sannong/apflights/img/DSCN0288.JPG

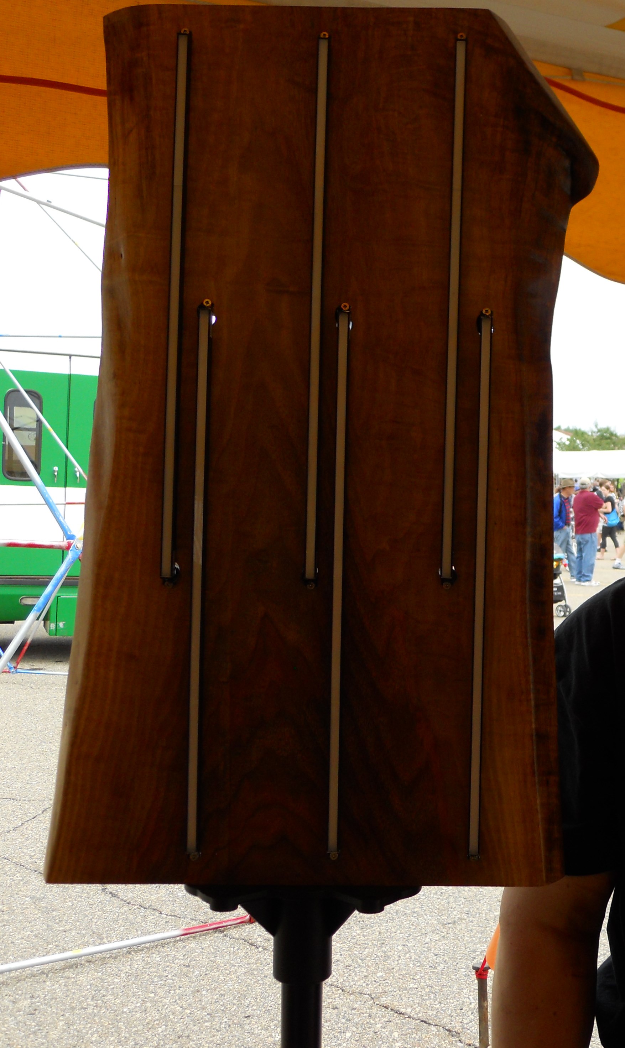
img/DSCN0288.JPG
