sannong/apflights/img/DSCN0460.jpg

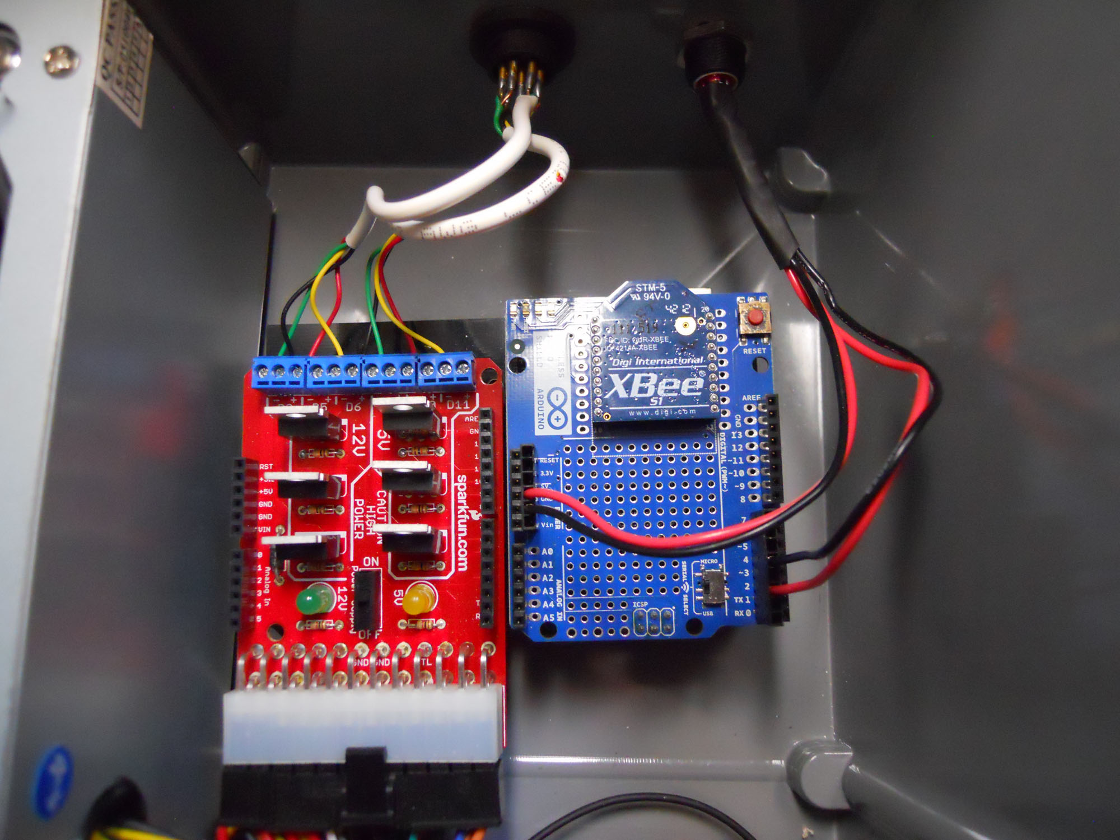
img/DSCN0460.jpg
