sannong/apflights/sch/host.pdf

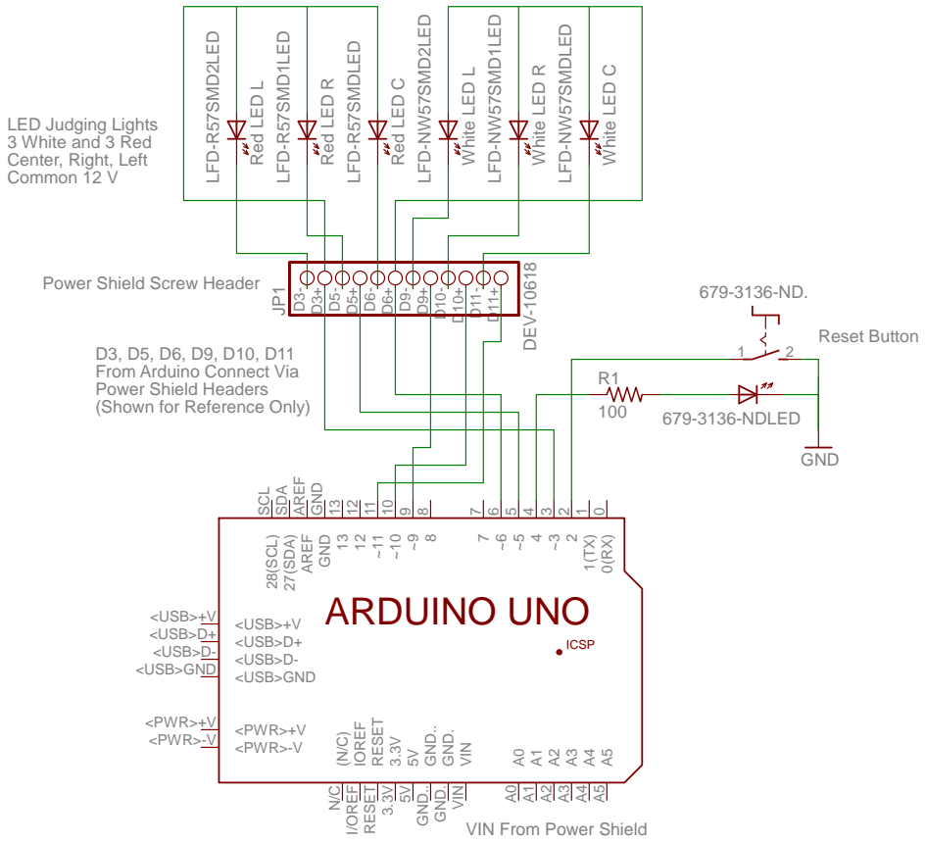
[picture p3: figure]
Power Shield Headers (Shown for Reference Only); LED Judging Lights; Center, Right, Left; 3 White and 3 Red; Reset Button; Common 12 V; VIN From Power Shield; D3, D5, D6, D9, D10, D11 From Arduino Connect Via; Power Shield Screw Header; GND; DEV-10618; Red LED L; Red LED R; Red LED C; White LED L; White LED R; White LED C; 28(SCL) SCL; 27(SDA) SDA; AREF AREF GND GND 13 13; <PWR>-V <PWR>-V <PWR>+V <PWR>+V; 679-3136-NDLED; LFD-R57SMD2LED; LFD-R57SMD1LED; LFD-R57SMDLED; LFD-NW57SMD2LED; LFD-NW57SMD1LED; LFD-NW57SMDLED; ARDUINO UNOICSP

# 0(RX) 0 A5 A5 A4 A4 A3 A3 A2 A2 A1 A1 A0 A0

VIN VIN GND. GND. GND.. GND.. 5V 5V 3.3V 3.3V RESET RESET IOREF I/OREF (N/C) N/C

<USB>GND <USB>GND <USB>D- <USB>D- <USB>D+ <USB>D+ <USB>+V <USB>+V
