sannong/apflights/sch/module.pdf

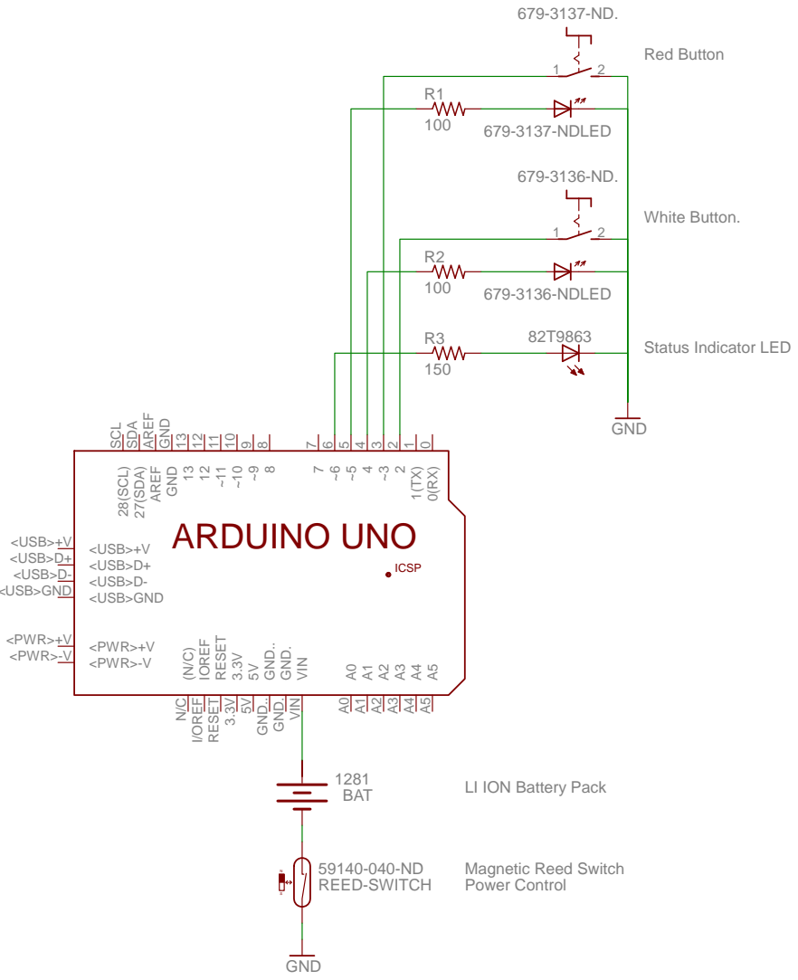
[picture p4: figure]
White Button.; Red Button; Magnetic Reed Switch Power Control; LI ION Battery Pack; Status Indicator LED; GND; BAT; REED-SWITCH; 28(SCL) SCL; 27(SDA) SDA; AREF AREF GND GND 13 13; <PWR>-V <PWR>-V <PWR>+V <PWR>+V; 679-3137-NDLED; 679-3136-NDLED; ARDUINO UNOICSP

# 0(RX) 0 A5 A5 A4 A4 A3 A3 A2 A2 A1 A1 A0 A0

VIN VIN GND. GND. GND.. GND.. 5V 5V 3.3V 3.3V RESET RESET IOREF I/OREF (N/C) N/C

<USB>GND <USB>GND <USB>D- <USB>D- <USB>D+ <USB>D+ <USB>+V <USB>+V
