sannong/apflights/sch/shield_connections.pdf

Arduino Uno | Wireless Shield | Xbee Module
| External Button/LED
| Connections Use Wirless
Digital Header | Shield Header

Analog/Power Headers

# Module Connections

Li Ion Battery

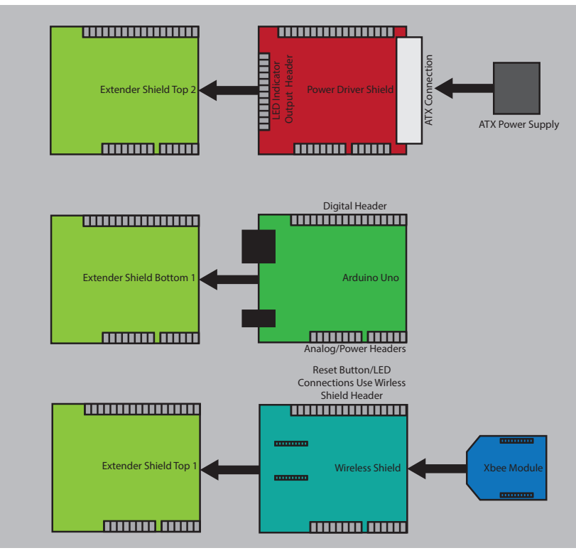
[picture p5: figure]
Extender Shield Top 2; Extender Shield Bottom 1; Extender Shield Top 1; Arduino Uno; Analog/Power Headers; Wireless Shield; Xbee Module; Power Driver Shield; ATX Connection; ATX Power Supply; LED Indicator; Output Header; Digital Header; Reset Button/LED Connections Use Wirless Shield Header

# Base Station Connections
