sannong/apflights/img/DSCN0250.JPG

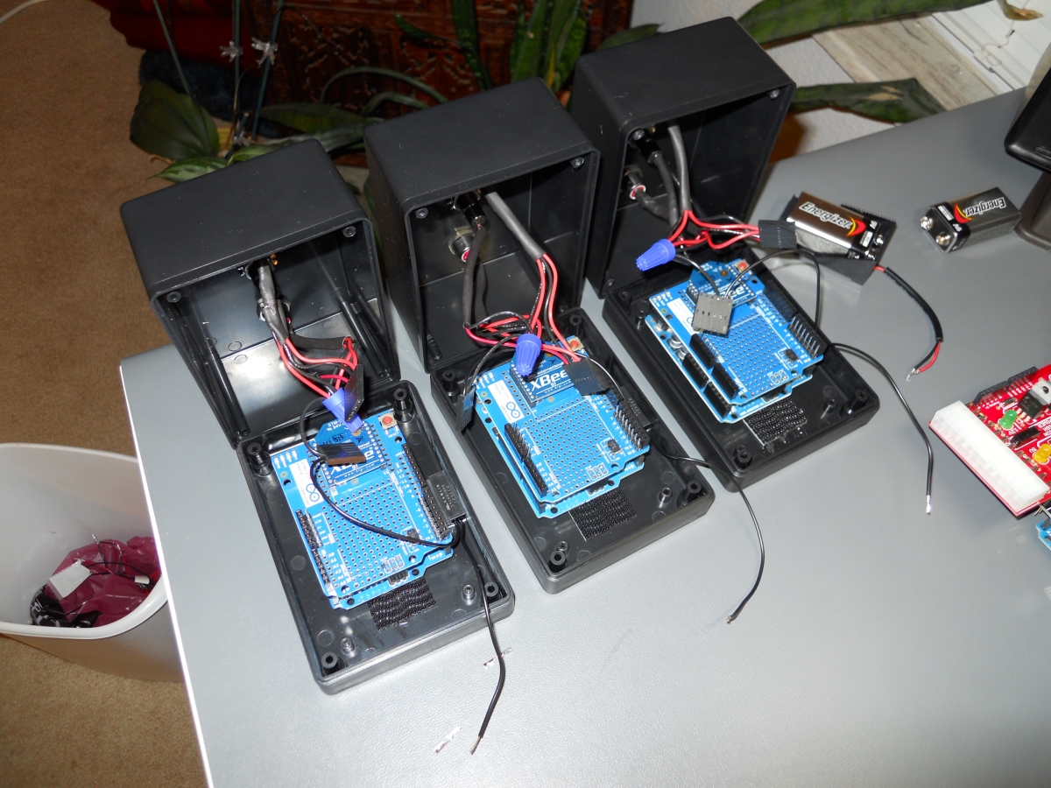
img/DSCN0250.JPG
