sannong/apflights/img/DSCN0252.JPG

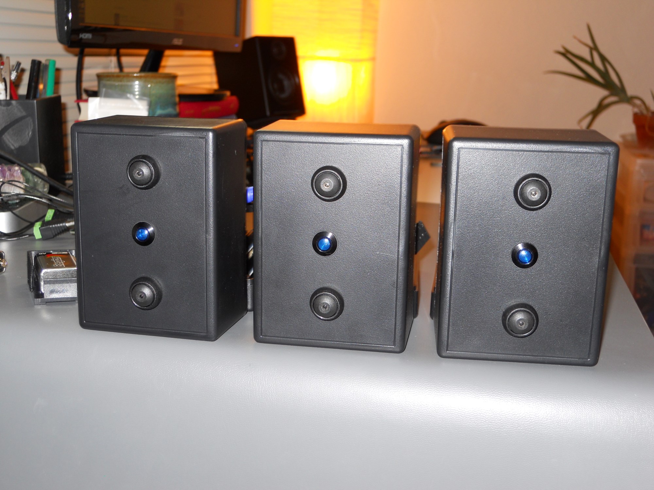
img/DSCN0252.JPG
