sannong/apflights/img/DSCN0254.JPG

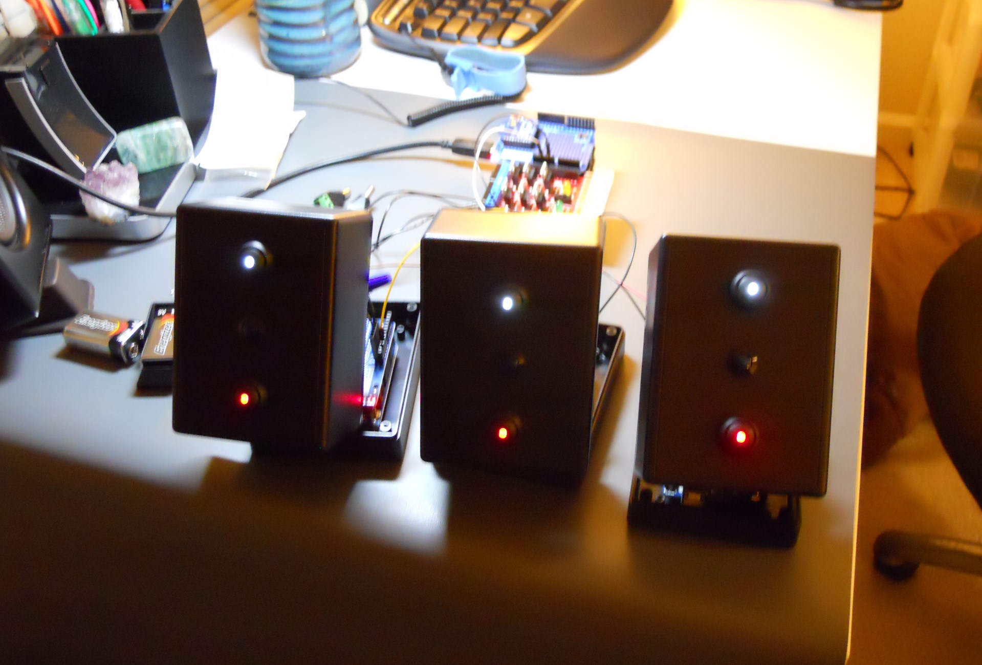
img/DSCN0254.JPG
