sannong/apflights/img/DSCN0255.JPG

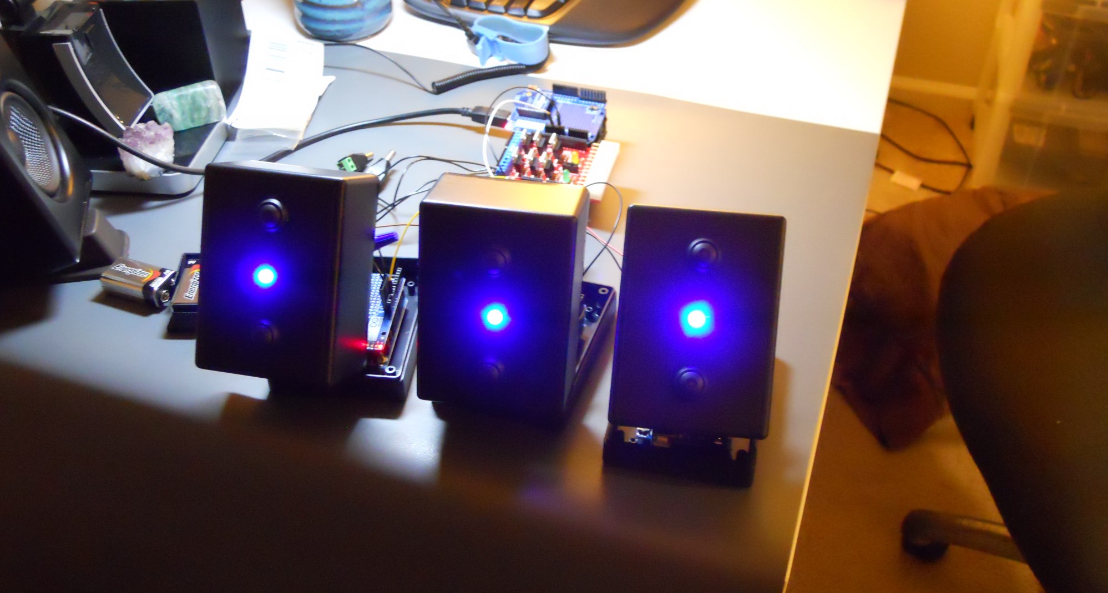
img/DSCN0255.JPG
