sannong/apflights/img/DSCN0260.JPG

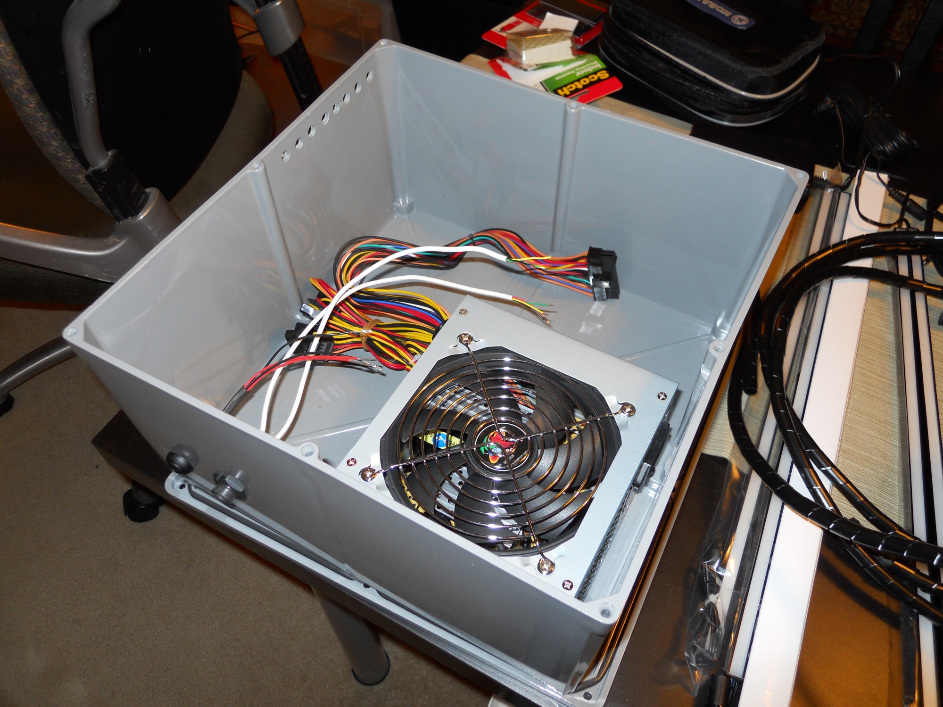
img/DSCN0260.JPG
