sannong/apflights/img/DSCN0455.jpg

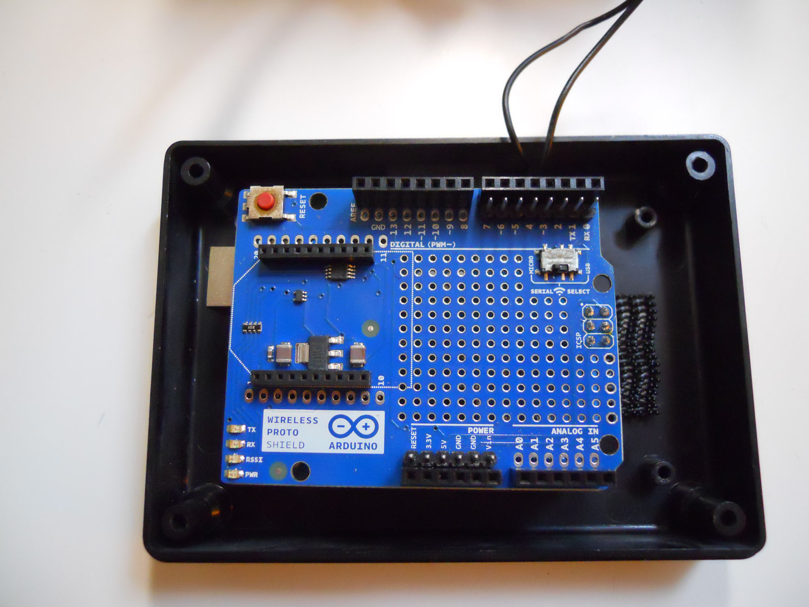
img/DSCN0455.jpg
