sannong/apflights/img/DSCN0456.jpg

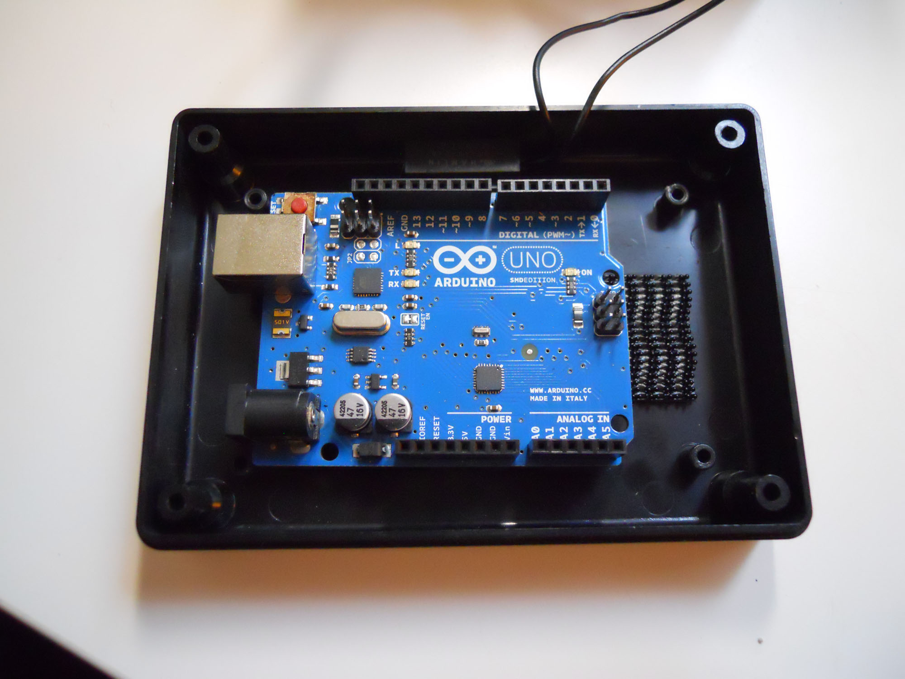
img/DSCN0456.jpg
