sannong/apflights/img/DSCN0457.jpg

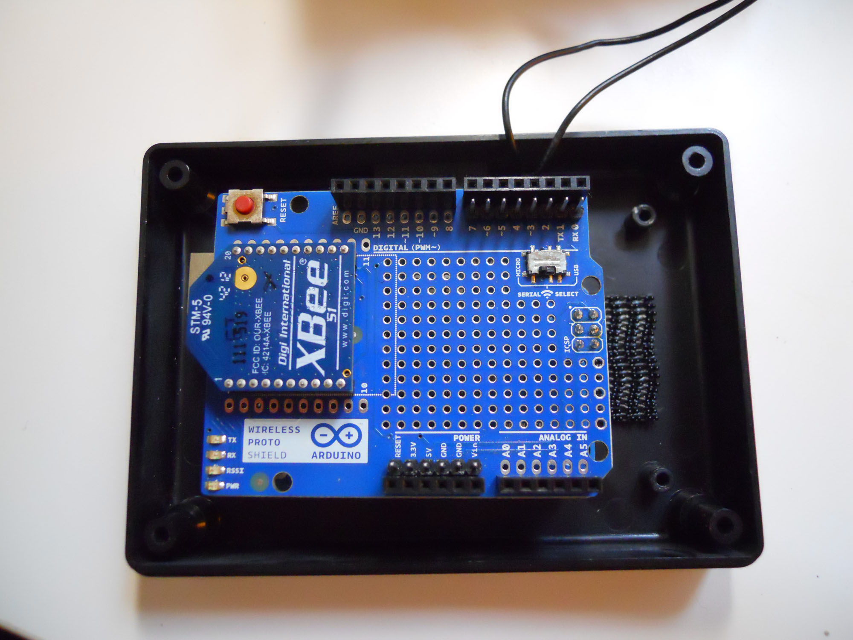
img/DSCN0457.jpg
