sannong/apflights/img/DSCN0458.jpg

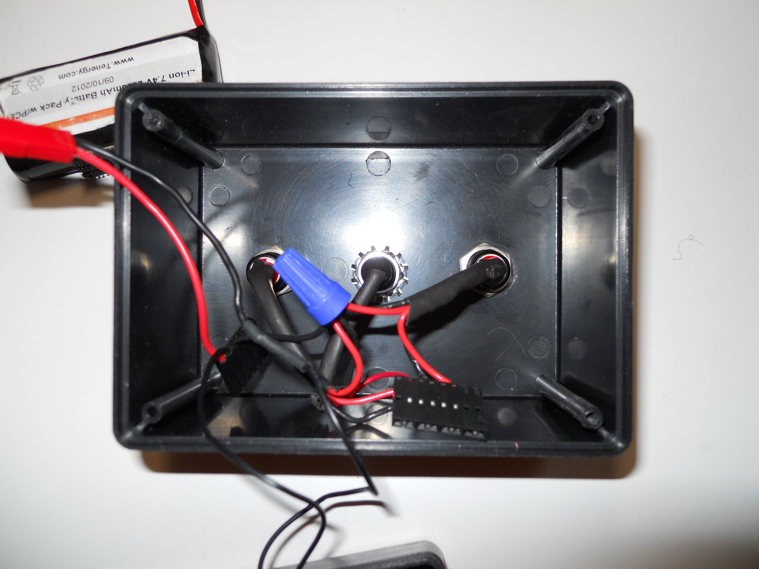
img/DSCN0458.jpg
