sannong/apflights/img/DSCN0459.jpg

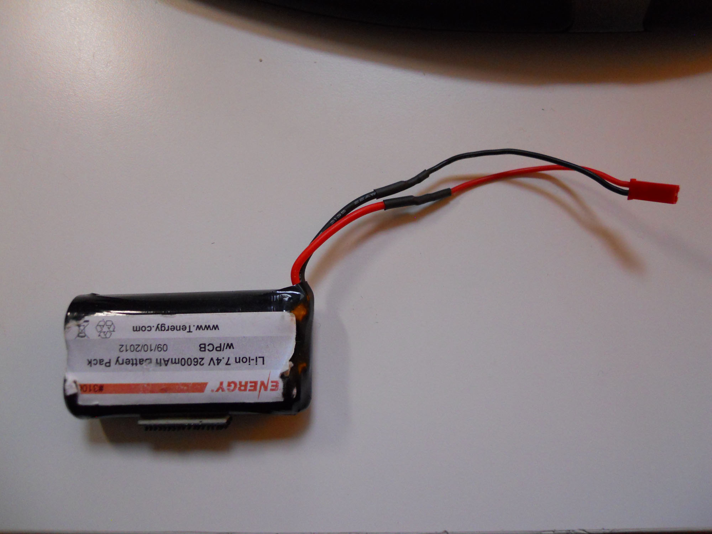
img/DSCN0459.jpg
