sannong/apflights/img/DSCN0461.jpg

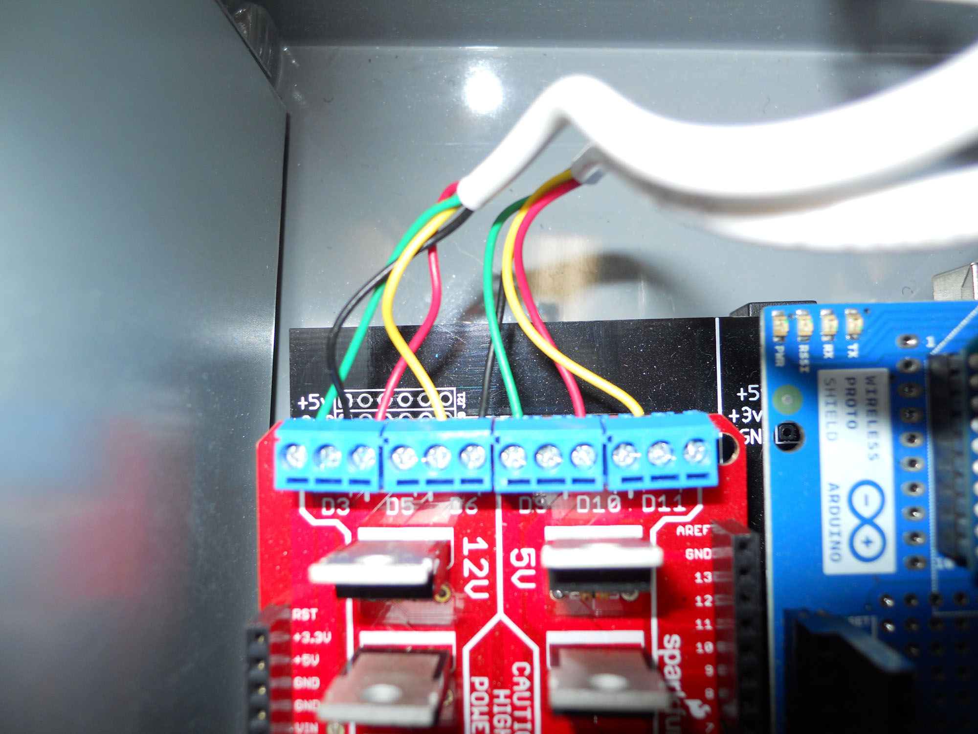
img/DSCN0461.jpg
