sannong/apflights/img/DSCN0462.jpg

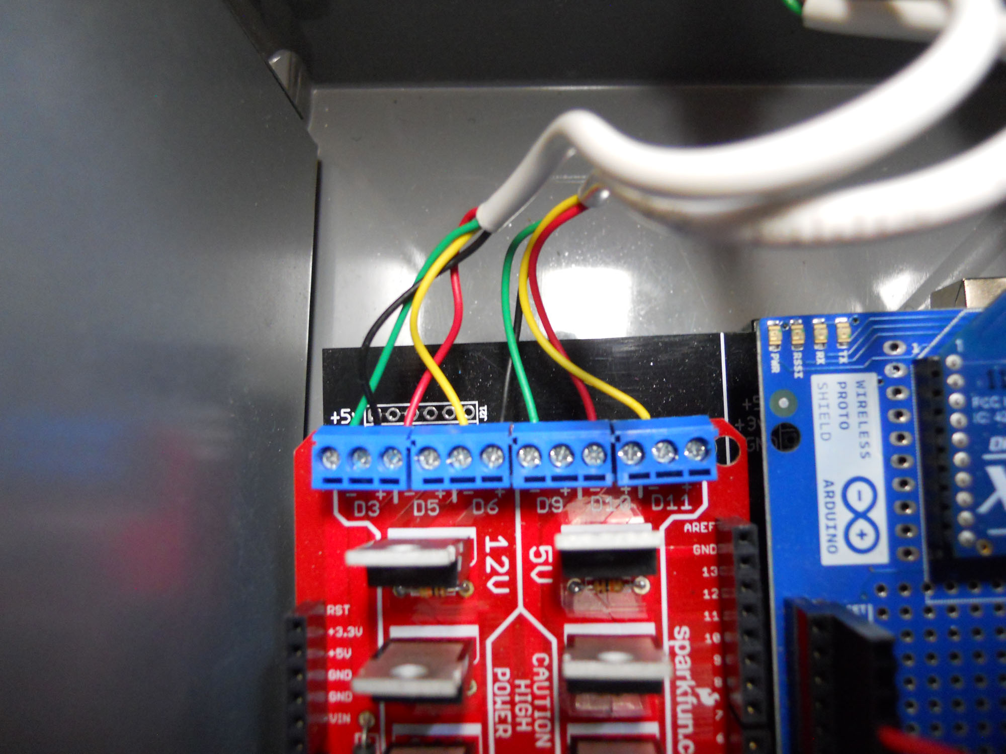
img/DSCN0462.jpg
