sannong/apflights/img/DSCN0463.jpg

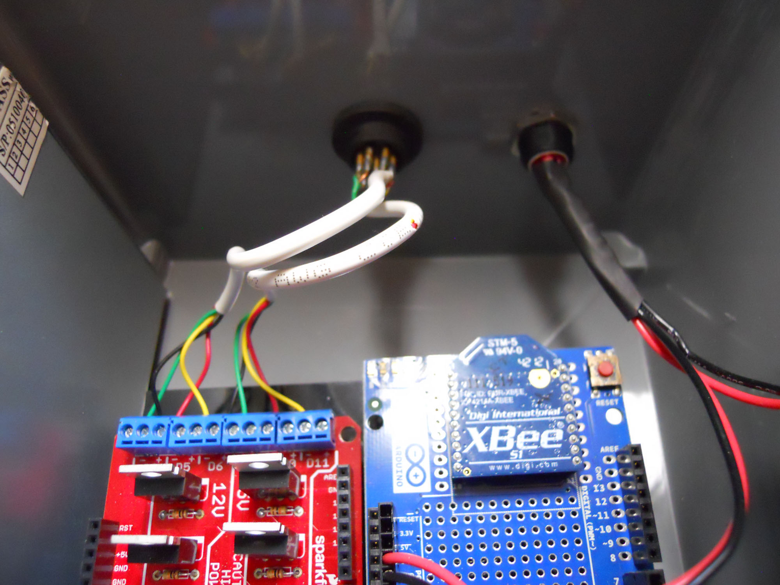
img/DSCN0463.jpg
