sannong/apflights/img/DSCN0464.jpg

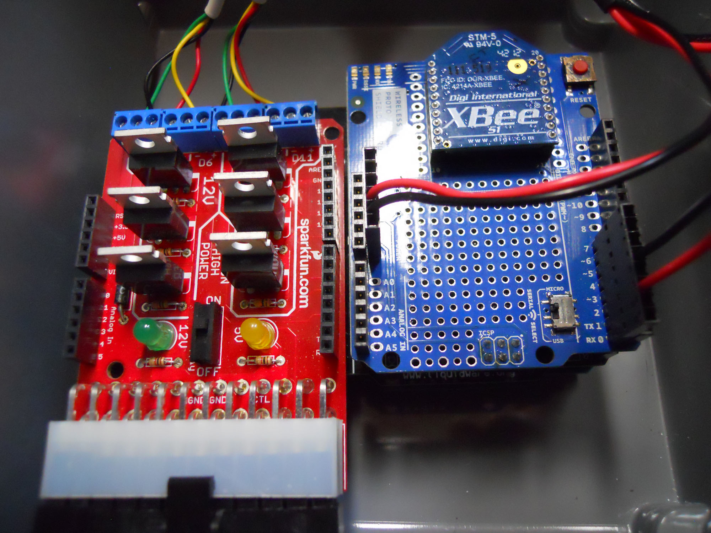
img/DSCN0464.jpg
