sannong/apflights/img/DSCN0465.jpg

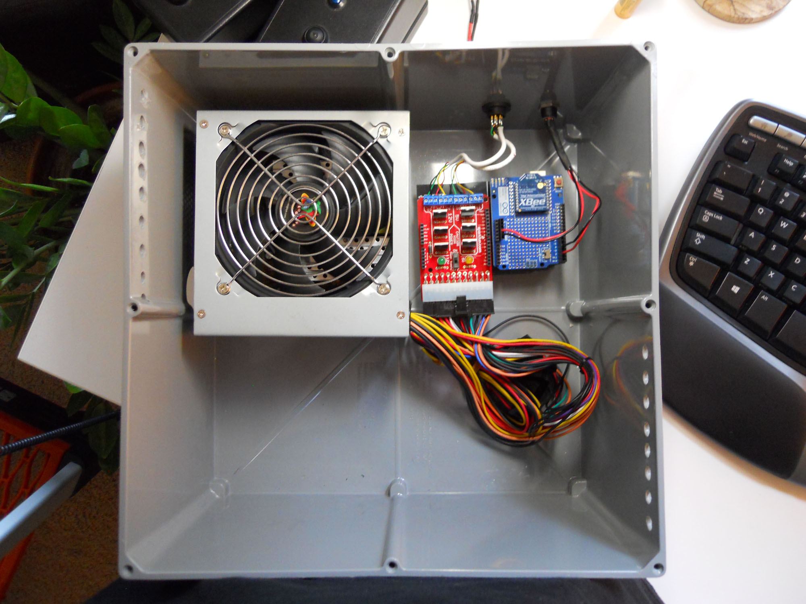
img/DSCN0465.jpg
