sannong/apflights/img/DSCN0466.jpg

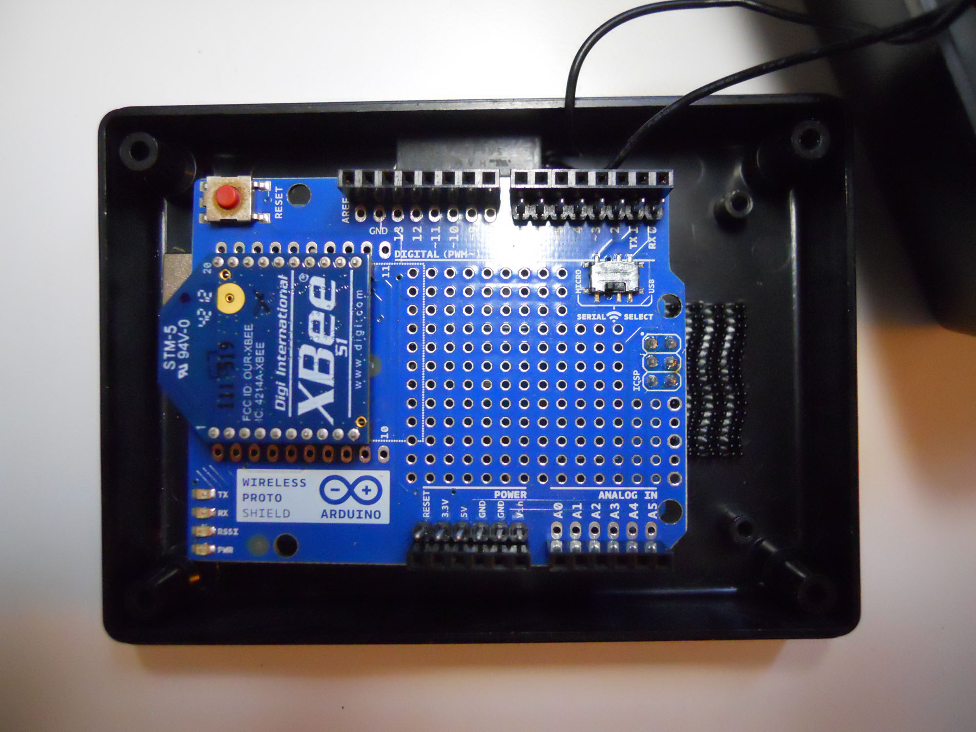
img/DSCN0466.jpg
