sannong/apflights/img/DSCN0467.jpg

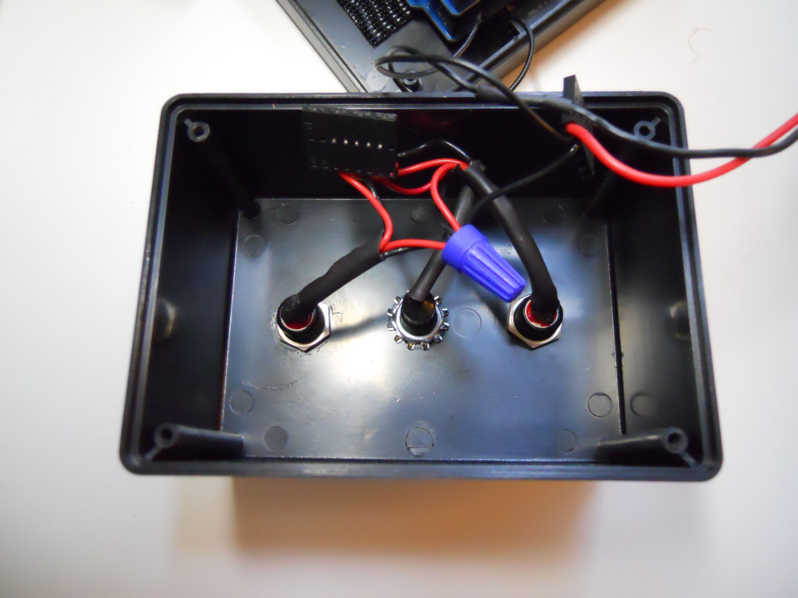
img/DSCN0467.jpg
