sannong/apflights/img/DSCN0468.jpg

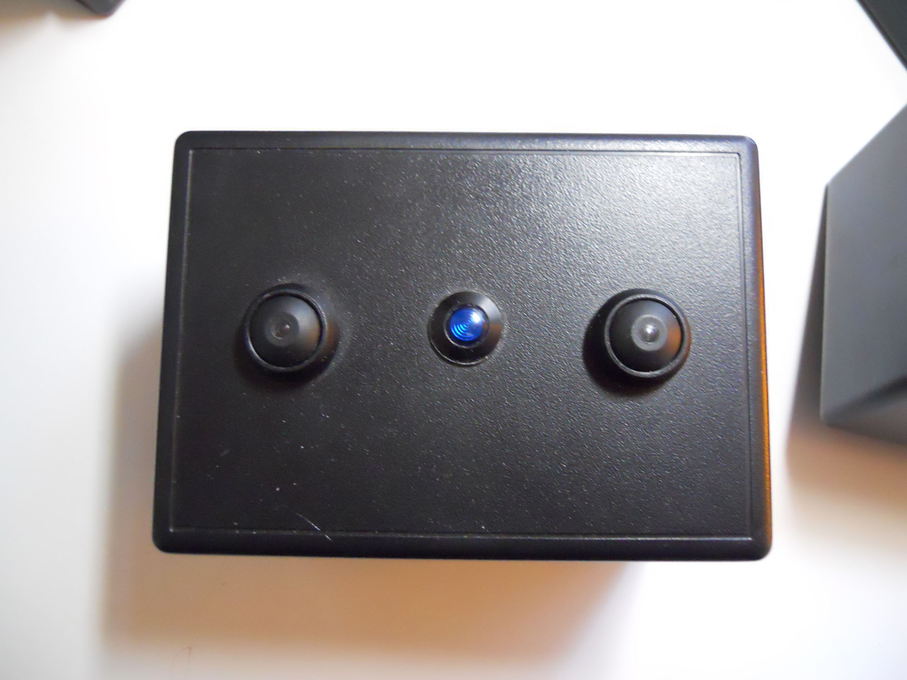
img/DSCN0468.jpg
