sannong/apflights/img/DSCN0469.jpg

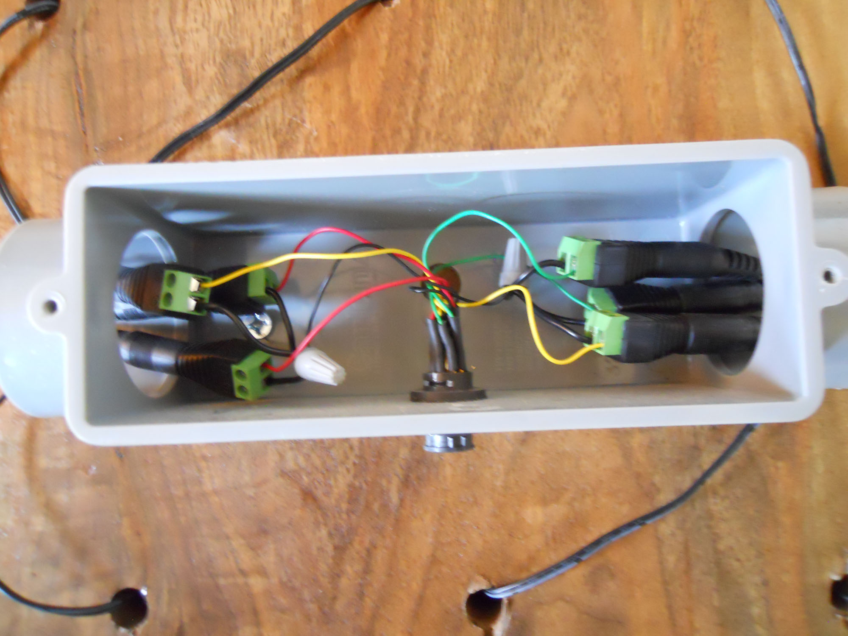
img/DSCN0469.jpg
