sannong/apflights/img/DSCN0470.jpg

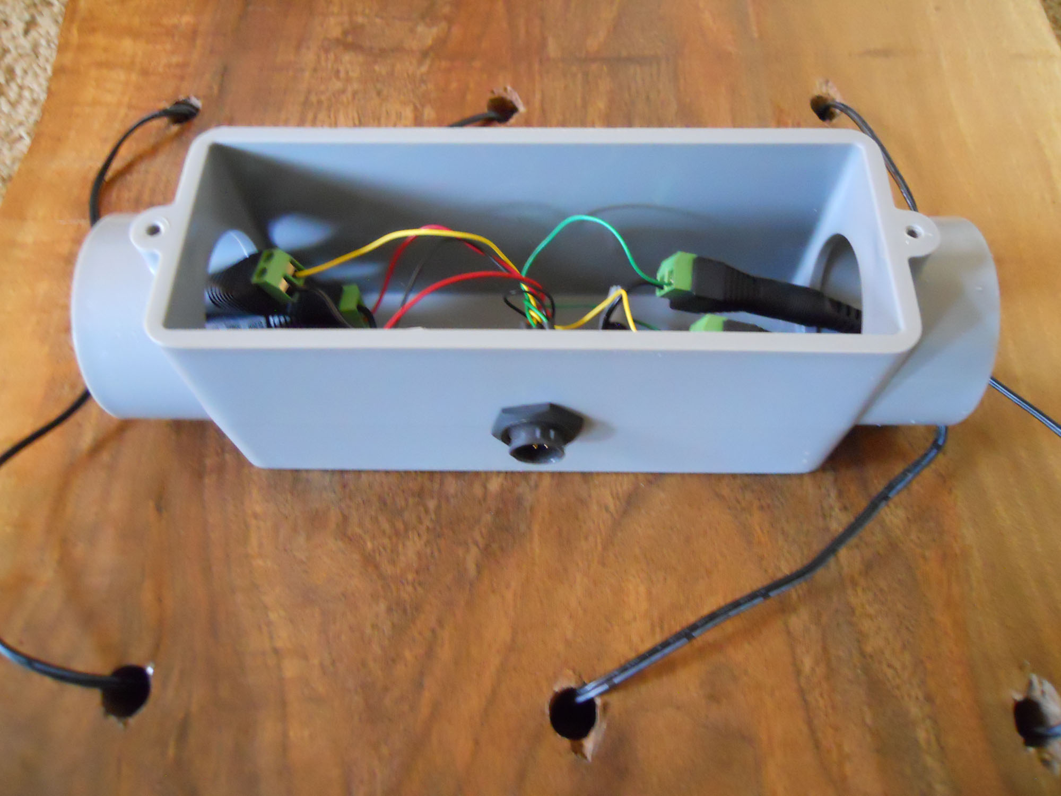
img/DSCN0470.jpg
