sannong/apflights/img/DSCN0471.jpg

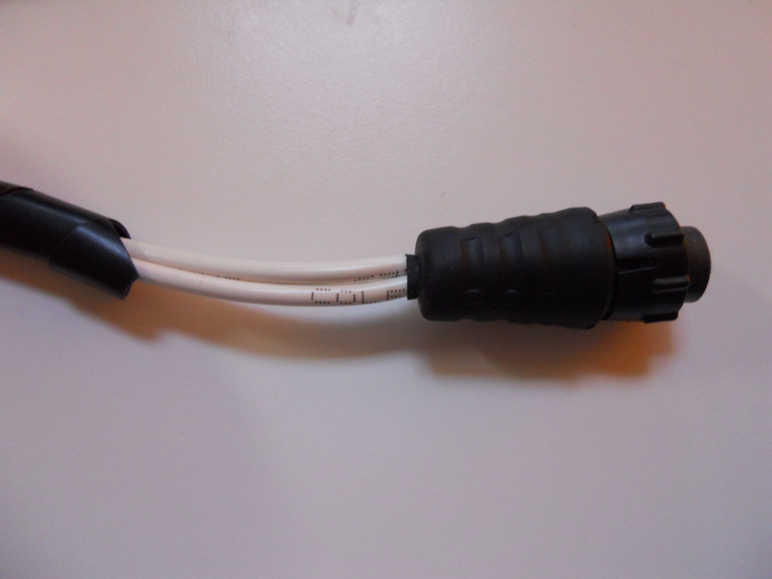
img/DSCN0471.jpg
