sannong/apflights/img/DSCN0472.jpg

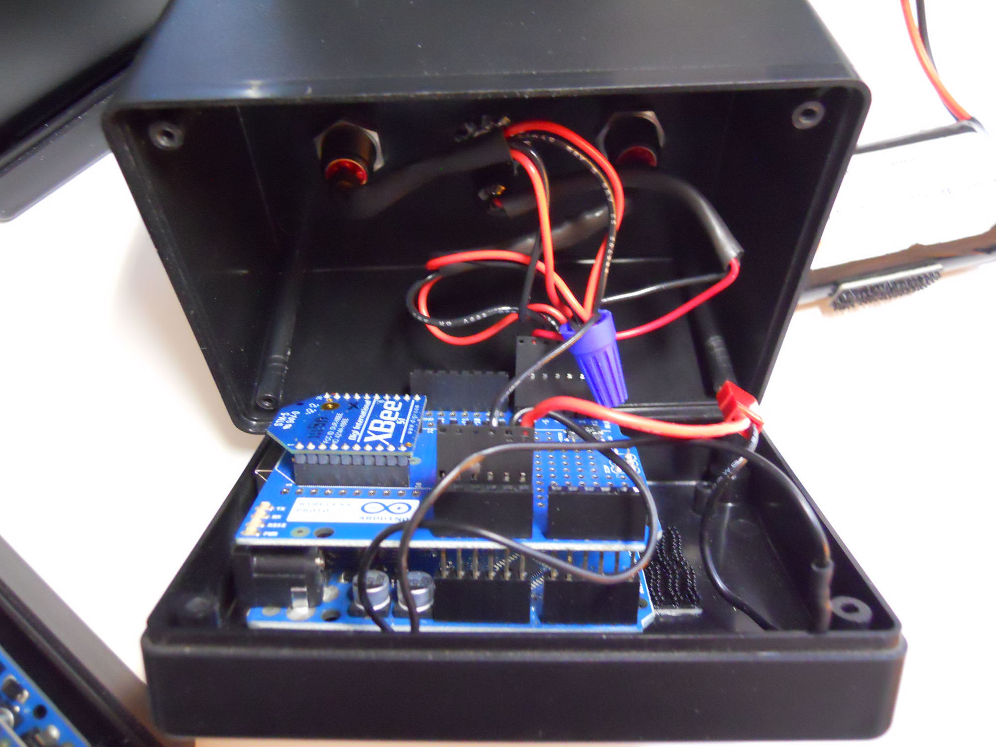
img/DSCN0472.jpg
