sannong/apflights/img/DSCN0473.jpg

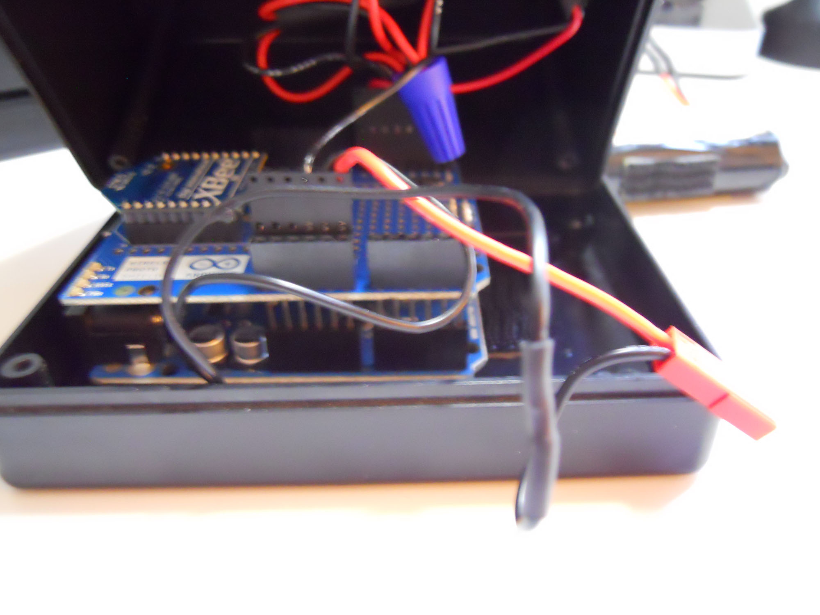
img/DSCN0473.jpg
