sannong/apflights/img/DSCN0474.jpg

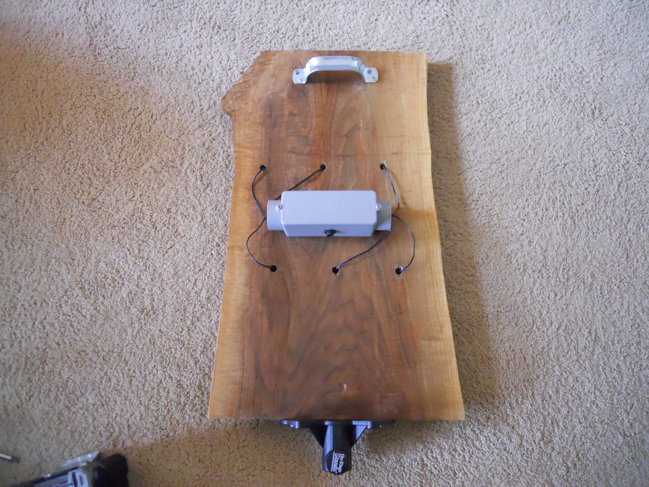
img/DSCN0474.jpg
