sannong/apflights/img/DSCN0475.jpg

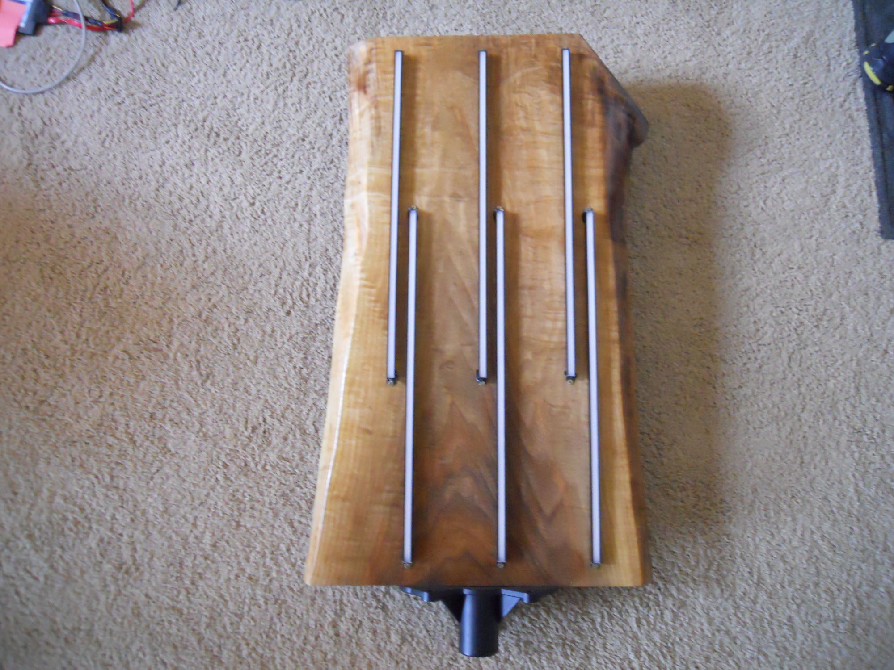
img/DSCN0475.jpg
