sannong/apflights/sch/BOM.xlsx

Required Parts
Index | Part Number | Description | Distributor | Quantity | Unit Price USD | Extended Price USD
 | 100QBK-ND | RES 100 OHM 1/4W 5% CARBON FILM (current control for button LED) | Digikey | 7 | 0.059 | $0.41
 | 150QBK-ND | RES 150 OHM 1/4W 5% CARBON FILM (current control for indicator LED) | Digikey | 3 | 0.059 | $0.18
 | 1050-1023-ND | ARDUINO SHIELD - WIRELESS | Digikey | 4 | 19.32 | $77.28
 | 1050-1041-ND | ARDUINO UNO SMD REV3 | Digikey | 4 | 24.64 | $98.56
 | 602-1273-ND | MOD XBEE 802.15.4 1MW W/PCB ANT | Digikey | 4 | 19 | $76.00
 | DEV-10618 | Power Driver Shield Kit | Sparkfun | 1 | 19.95 | $19.95
 | n/a | DoubleWide Extender Shield (http://www.liquidware.com/shop/show/DWX/DoubleWide+ExtenderShield) | Liquidware | 1 | 19.65 | $19.65
 | WRL-11812 | SparkFun XBee Explorer USB (used to program the Xbee module) http://www.sparkfun.com/products/11812 | Sparkfun | 1 | 24.95 | $24.95
 | PRT-08830 | Heat Shrink - Black 5' x 1/4" | Sparkfun | 1 | 1.95 | $1.95
 | WM2510-ND | CONN TERM FEMALE 22-24AWG TIN | Digikey | 32 | 0.0882 | $2.82
 | WM2806-ND | CONN HOUSING 8POS .100 SINGLE | Digikey | 4 | 0.7 | $2.80
 | WM8078-ND | CONN HEADER 8POS .100" STR TIN | Digikey | 4 | 0.9 | $3.60
 | WM2804-ND | CONN HOUSING 6POS .100 SINGLE | Digikey | 4 | 0.62 | $2.48
 | WM8076-ND | CONN HEADER 6POS .100" STR TIN | Digikey | 4 | 0.77 | $3.08
 | 1281 | Tenergy TLP-4000 Universal 1A Smart Charger for Li-Ion/Polymer Battery Pack (3.7V-14.8V 1-4 Cell) | all-battery.com | 1 | 24.95 | $24.95
 | 31004 | AT(i): Tenergy Li-Ion 18650 7.4V 2600mAh PCB Protected Battery Module w/ 22AWG Bare Leads | all-battery.com | 3 | 13.99 | $41.97
 | 80005 | A Pair of BEC (JST) Male and Female Connectors with Leads | all-battery.com | 4 | 2.28 | $9.12
 |  |  |  |  | Subtotal: | $409.75
Interchangeable Parts
Index | Part Number | Description | Distributor | Quantity | Unit Price USD | Extended Price USD
 | 679-3136-ND | SWITCH PUSHBUTTON SPST-NO 2A 24V | Digikey | 3 | 18.72 | $56.16
 | 679-3137-ND | SWITCH PUSHBUTTON SPST-NO 2A 24V | Digikey | 3 | 15.92 | $47.76
 | 679-3122-ND | SWITCH PUSHBUTTON SPST-NO 2A 24V | Digikey | 1 | 18.83 | $18.83
 | 82T9863 | LED PANEL MOUNT INDICATOR, BLUE, 3V | Newark | 3 | 12.8 | $38.40
 | 59140-040-ND | SENSOR MAGNETIC SPST-NC .5A | Digikey | 3 | 4.81 | $14.43
 | 57140-000-ND | MAGNET COMPACT FLNGEMT FOR 59140 | Digikey | 3 | 3.15 | $9.45
 | 377-1976-ND | BOX ABS 4.50X3.25X2.70" BLK | Digikey | 3 | $8.10 | $24.30
 | SC268-ND | CONN RCPT 8POS MALE PANEL #20 (8 pos cable connector) | Digikey | 2 | 9.16 | $18.32
 | SC259-ND | CONN PLUG 8POS FEMALE CORD #20 (8 pos cable connector) | Digikey | 2 | 15.32 | $30.64
 | N82E16817152032 | RAIDMAX RX-450K 450W ATX12V Power Supply | Newegg | 1 | 24.99 | $24.99
 | Box | Base station holding box from Lowes | Lowes | 1 | 30 | $30.00
 | LFD-NW57SMD | LFD-xSMD: LFD series Linear Light Bar Fixture LFD-NW57SMD: Natural White | superbrightleds.com | 3 | 19.95 | $59.85
 | LFD-R57SMD | LFD-xSMD: LFD series Linear Light Bar Fixture LFD-R57SMD: Red | superbrightleds.com | 3 | 19.95 | $59.85
 | CPS-M2ST | CPS-x2ST: CPS-x2ST Standard Barrel Connector to Screw Terminal Adapter CPS-M2ST: Male Standard 5mm Connector to Screw Terminal Adapter | superbrightleds.com | 6 | 1.95 | $11.70
 |  |  |  |  | Subtotal: | $444.68
 |  |  |  |  | Total: | $854.43
