sannong/apflights/sch/host.sch

## EAGLE design sch/host.sch (2015-04-05)

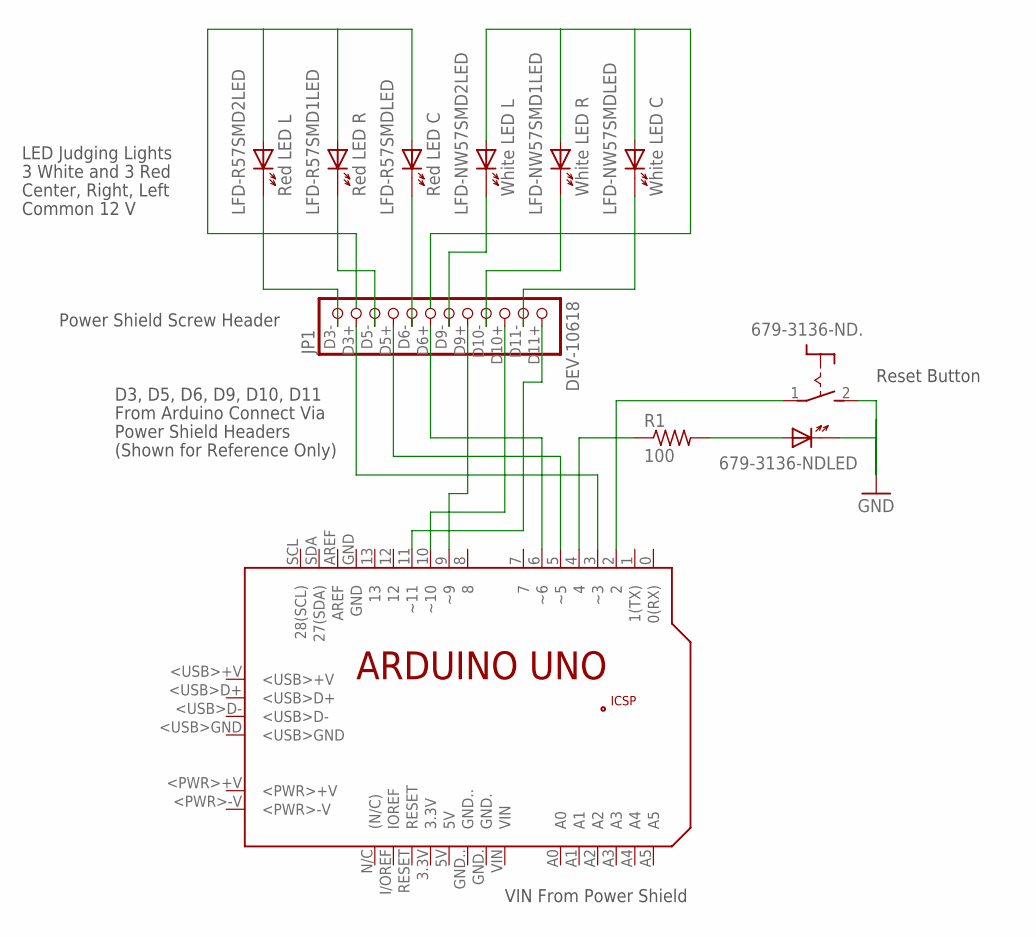
[picture p31: schematic host.sch]

Parts:
679-3136-ND: MARQ6425
JP1: DEV-10618; 1X12
LFD-NW57SMD: White LED C; MARQ6425
LFD-NW57SMD1: White LED R; MARQ6425
LFD-NW57SMD2: White LED L; MARQ6425
LFD-R57SMD: Red LED C; MARQ6425
LFD-R57SMD1: Red LED R; MARQ6425
LFD-R57SMD2: Red LED L; MARQ6425
PCB1: ARDUINO_UNO
R1: 100; 0204V

Connections:
GND: 679-3136-ND.2 (S), 679-3136-ND.K
unnamed: 679-3136-ND.1, PCB1.2
unnamed: PCB1.4, R1.1
unnamed: JP1.D11+, PCB1.11 (~11)
unnamed: JP1.D10+, PCB1.10 (~10)
unnamed: JP1.D9+, PCB1.9 (~9)
unnamed: JP1.D3+, PCB1.3 (~3)
unnamed: JP1.D5+, PCB1.5 (~5)
unnamed: JP1.D6+, PCB1.6 (~6)
unnamed: 679-3136-ND.A, R1.2
unnamed: JP1.D3-, LFD-R57SMD2.K
unnamed: JP1.D5-, LFD-R57SMD1.K
unnamed: JP1.D6-, LFD-R57SMD.K
unnamed: JP1.D11-, LFD-NW57SMD.K
unnamed: JP1.D10-, LFD-NW57SMD1.K
unnamed: JP1.D9-, LFD-NW57SMD2.K
unnamed: LFD-R57SMD.A, LFD-R57SMD1.A, LFD-R57SMD2.A
unnamed: LFD-NW57SMD.A, LFD-NW57SMD1.A, LFD-NW57SMD2.A

Notes on the sheet:
Power Shield Headers
(Shown for Reference Only)
LED Judging Lights
Center, Right, Left
3 White and 3 Red
Reset Button
Common 12 V
VIN From Power Shield
D3, D5, D6, D9, D10, D11
From Arduino Connect Via
Power Shield Screw Header
