sannong/apflights/sch/module.sch

## EAGLE design sch/module.sch (2015-04-05)

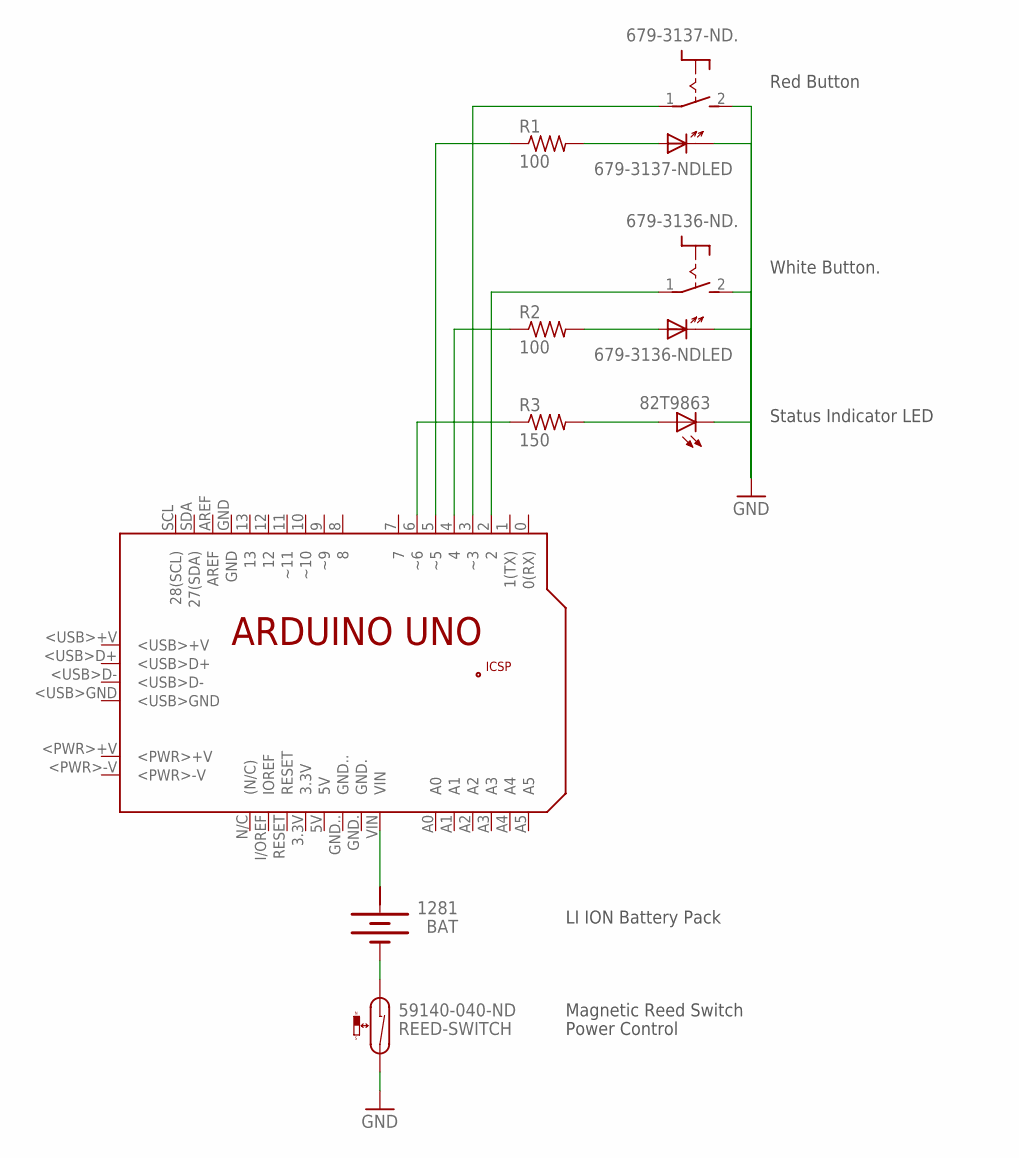
[picture p32: schematic module.sch]

Parts:
82T9863: LEDSQR5.7X3.2; U57X32
679-3136-ND, 679-3137-ND: MARQ6425
1281: BAT; BATTERY
59140-040-ND: REED-SWITCH; MK6-4
PCB1: ARDUINO_UNO
R1, R2: 100; 0204V
R3: 150; 0204V

Connections:
GND: 82T9863.K (C), 679-3136-ND.2 (S), 679-3136-ND.K, 679-3137-ND.2 (S), 679-3137-ND.K, 59140-040-ND.2
unnamed: 679-3136-ND.1, PCB1.2
unnamed: PCB1.4, R2.1
unnamed: 679-3137-ND.1, PCB1.3 (~3)
unnamed: PCB1.5 (~5), R1.1
unnamed: PCB1.6 (~6), R3.1
unnamed: 1281.+, PCB1.VIN
unnamed: 1281.-, 59140-040-ND.1
unnamed: 679-3136-ND.A, R2.2
unnamed: 679-3137-ND.A, R1.2
unnamed: 82T9863.A, R3.2

Notes on the sheet:
White Button.
Red Button
Magnetic Reed Switch
Power Control
LI ION Battery Pack
Status Indicator LED
