sannong/apflights/(commit log)

2014-12-27 Update: more robust message control and reduced BAUD rate for x-bee to 9600 (better stability).
    [common_control.h, host_control.h, host_control.ino, module_control.ino]
2014-12-28 Added schematics and updated BOM
    [BOM.xlsx, host.sch, module.sch]
2014-12-28 Updated readme, correct host LED connections in schematic, added Xbee programmer to BOM.
    [BOM.xlsx, host.sch]
2015-04-05 Cleaned up schematics, more clearly labeled.
    [host.sch, module.sch]
2015-04-05 Fixed bug in button timer when communication with host station is lost.
    [module_control.h, module_control.ino]
